Abhinavkrishna3211/CamoBots/hardware/blaster.pdf

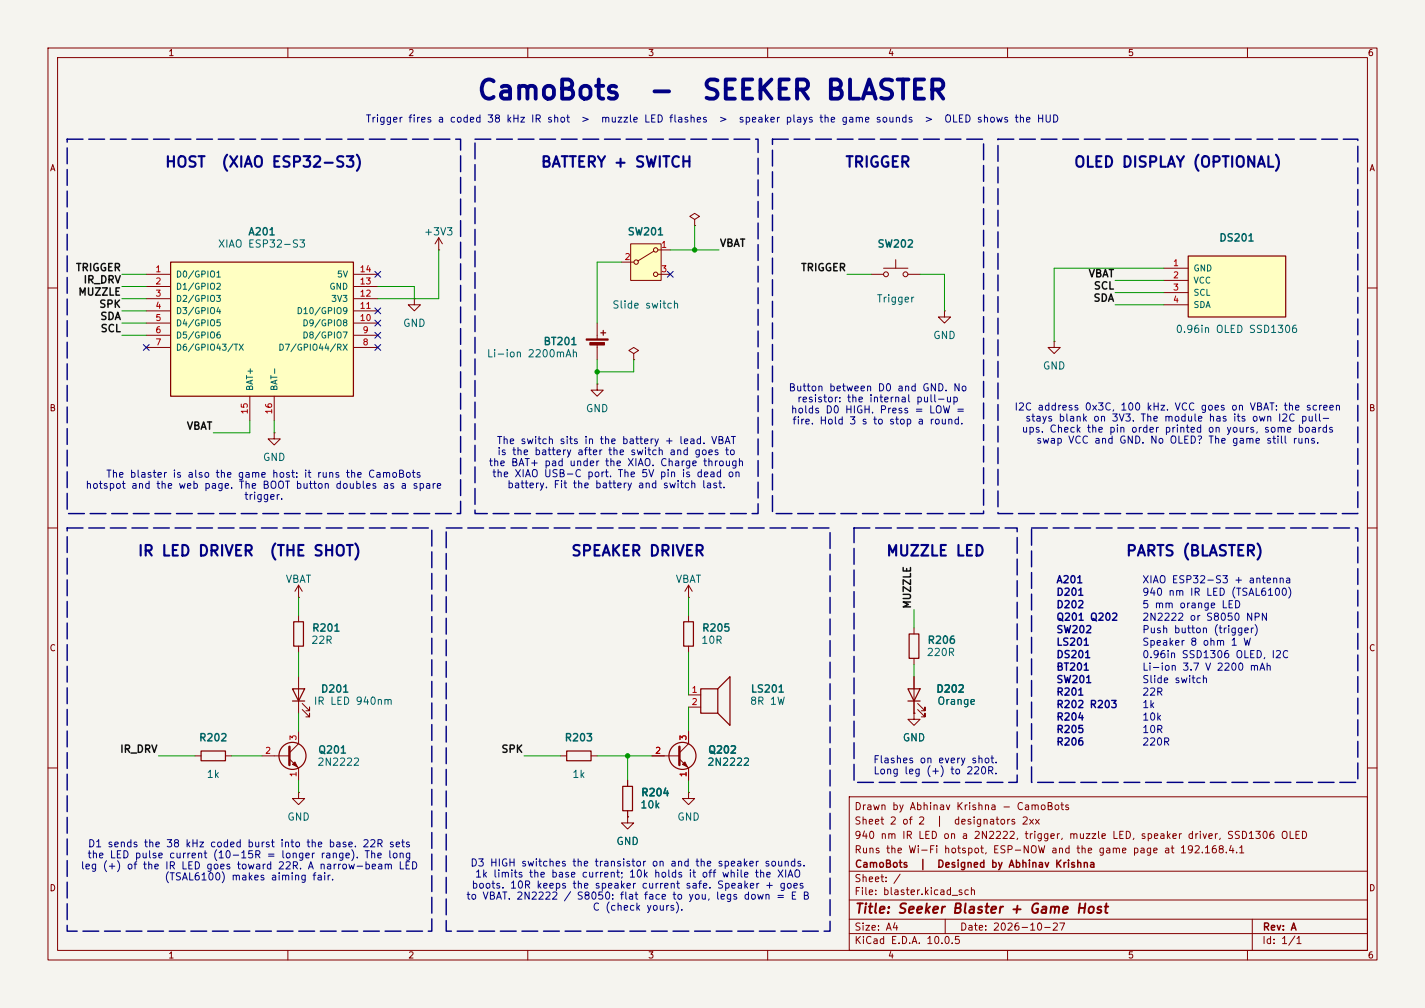
[picture p3: page 1]

I2C address 0x3C, 100 kHz. VCC goes on VBAT: the screen CamoBots - SEEKER BLASTER

Trigger fires a coded 38 kHz IR shot > muzzle LED flashes > speaker plays the game sounds > OLED shows the HUD

Button between D0 and GND. No
resistor: the internal pull-up
holds D0 HIGH. Press = LOW =
fire. Hold 3 s to stop a round.

stays blank on 3V3. The module has its own I2C pull-
swap VCC and GND. No OLED? The game still runs. ups. Check the pin order printed on yours, some boards

The switch sits in the battery + lead. VBAT
is the battery after the switch and goes to
the BAT+ pad under the XIAO. Charge through
the XIAO USB-C port. The 5V pin is dead on
battery. Fit the battery and switch last.

The blaster is also the game host: it runs the CamoBots
hotspot and the web page. The BOOT button doubles as a spare

IR LED DRIVER (THE SHOT)

Flashes on every shot.
Long leg (+) to 220R.

Drawn by Abhinav Krishna - CamoBots
Sheet 2 of 2 | designators 2xx
940 nm IR LED on a 2N2222, trigger, muzzle LED, speaker driver, SSD1306 OLED
Runs the Wi-Fi hotspot, ESP-NOW and the game page at 192.168.4.1
CamoBots | Designed by Abhinav Krishna
Sheet: /
File: blaster.kicad_sch
Title: Seeker Blaster + Game Host

D1 sends the 38 kHz coded burst into the base. 22R sets
the LED pulse current (10-15R = longer range). The long
leg (+) of the IR LED goes toward 22R. A narrow-beam LED

D3 HIGH switches the transistor on and the speaker sounds.
1k limits the base current; 10k holds it off while the XIAO
boots. 10R keeps the speaker current safe. Speaker + goes
to VBAT. 2N2222 / S8050: flat face to you, legs down = E B

Size: A4 | Rev: A
KiCad E.D.A. 10.0.5 | Id: 1/1
