Abhinavkrishna3211/CamoBots/hardware/body.pdf

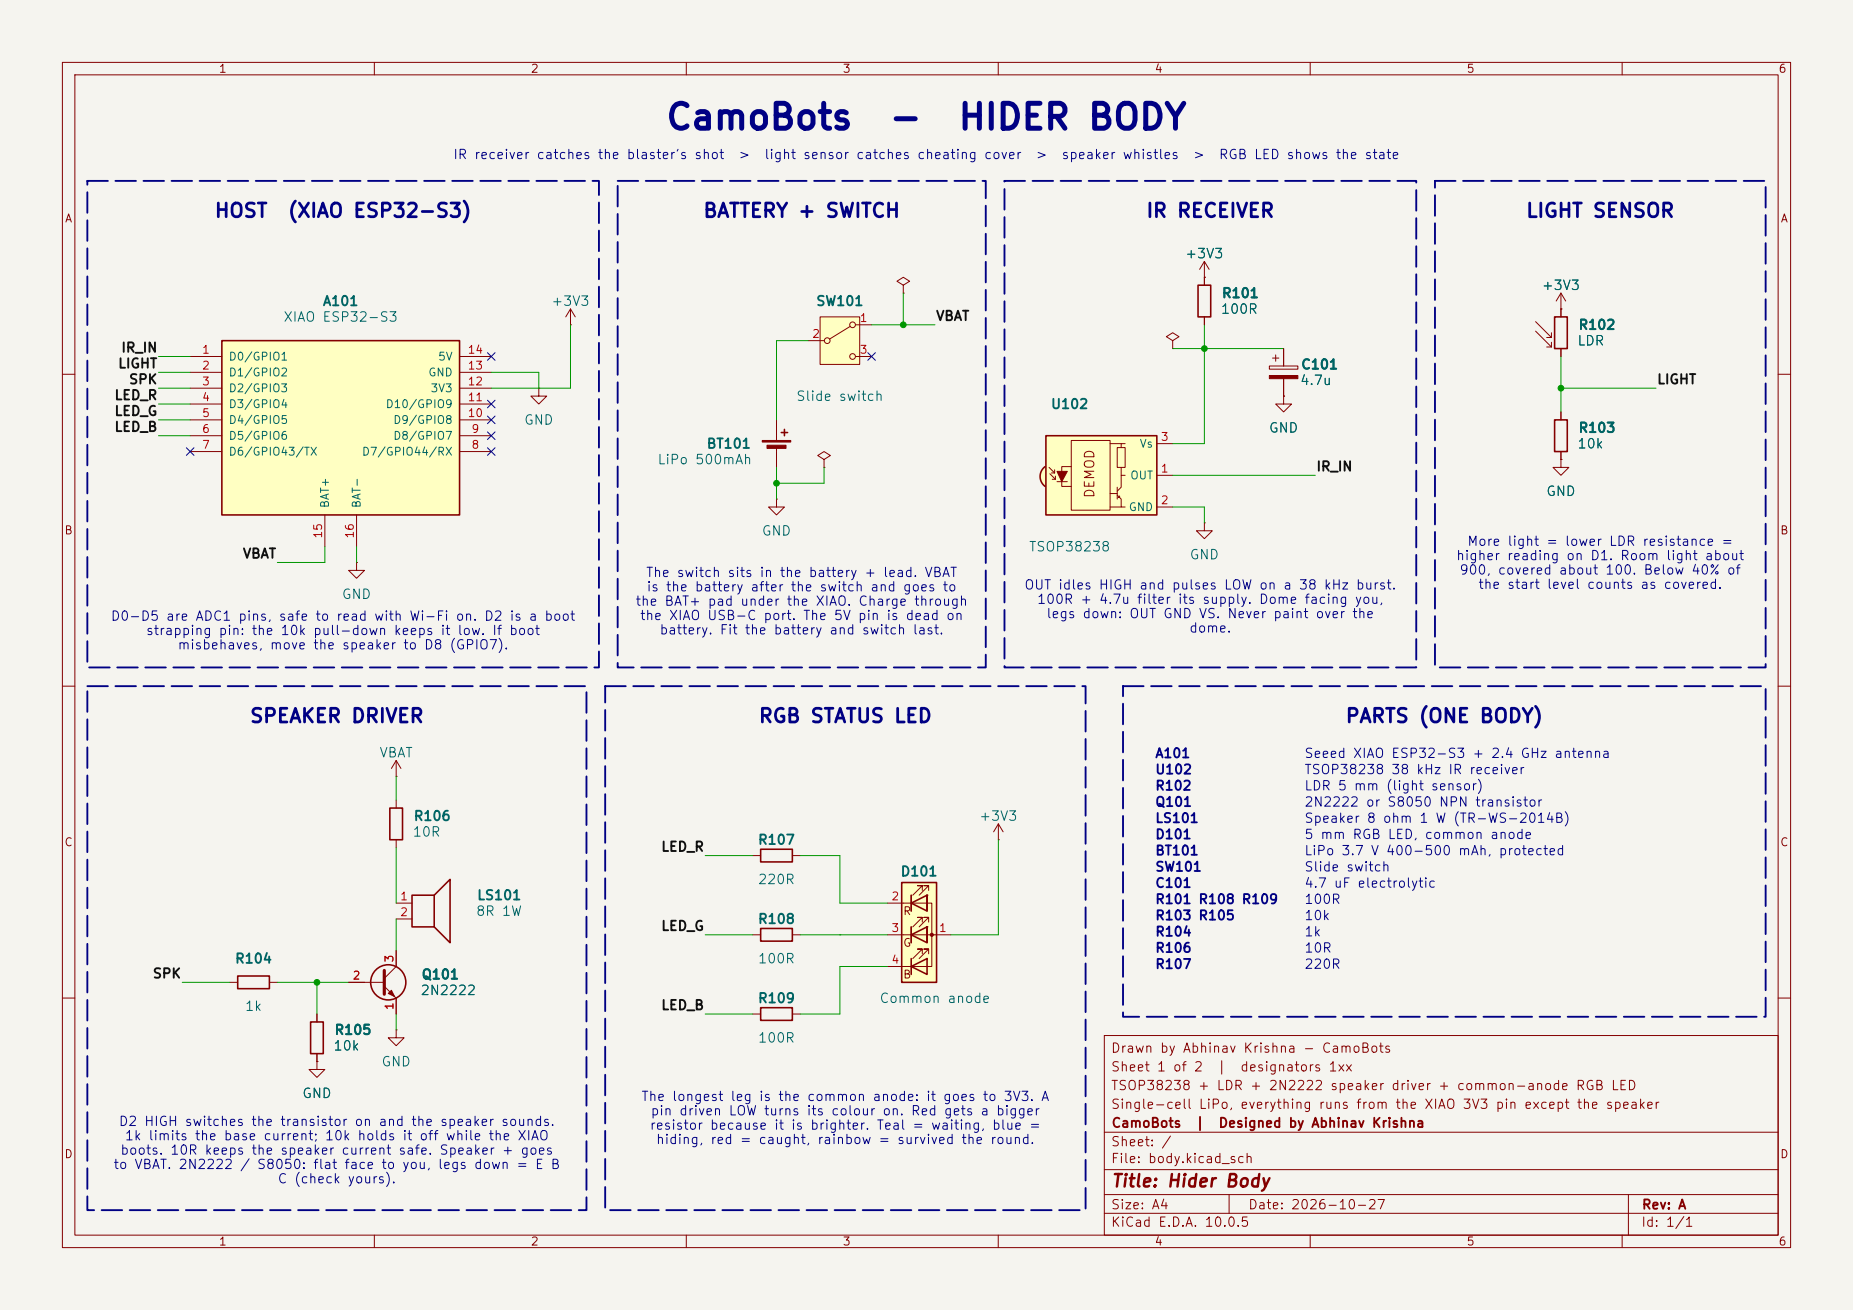
[picture p4: page 1]

IR receiver catches the blaster's shot > light sensor catches cheating cover > speaker whistles > RGB LED shows the state

More light = lower LDR resistance =
higher reading on D1. Room light about
900, covered about 100. Below 40% of
the start level counts as covered.

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

OUT idles HIGH and pulses LOW on a 38 kHz burst.
100R + 4.7u filter its supply. Dome facing you,
legs down: OUT GND VS. Never paint over the

D0-D5 are ADC1 pins, safe to read with Wi-Fi on. D2 is a boot

strapping pin: the 10k pull-down keeps it low. If boot
misbehaves, move the speaker to D8 (GPIO7).

Seeed XIAO ESP32-S3 + 2.4 GHz antenna
TSOP38238 38 kHz IR receiver
LDR 5 mm (light sensor)
2N2222 or S8050 NPN transistor
Speaker 8 ohm 1 W (TR-WS-2014B)
5 mm RGB LED, common anode
LiPo 3.7 V 400-500 mAh, protected
Slide switch
4.7 uF electrolytic

Drawn by Abhinav Krishna - CamoBots
Sheet 1 of 2 | designators 1xx
TSOP38238 + LDR + 2N2222 speaker driver + common-anode RGB LED
Single-cell LiPo, everything runs from the XIAO 3V3 pin except the speaker
CamoBots | Designed by Abhinav Krishna
Sheet: /
File: body.kicad_sch
Title: Hider Body

The longest leg is the common anode: it goes to 3V3. A
pin driven LOW turns its colour on. Red gets a bigger
resistor because it is brighter. Teal = waiting, blue =
hiding, red = caught, rainbow = survived the round.

D2 HIGH switches the transistor on and the speaker sounds.
1k limits the base current; 10k holds it off while the XIAO
boots. 10R keeps the speaker current safe. Speaker + goes
to VBAT. 2N2222 / S8050: flat face to you, legs down = E B

Size: A4 | Rev: A
KiCad E.D.A. 10.0.5 | Id: 1/1
