Abhinavkrishna3211/CamoBots/hardware/blaster.kicad_sch

## KiCad design hardware/blaster.kicad_sch (2026-10-26)

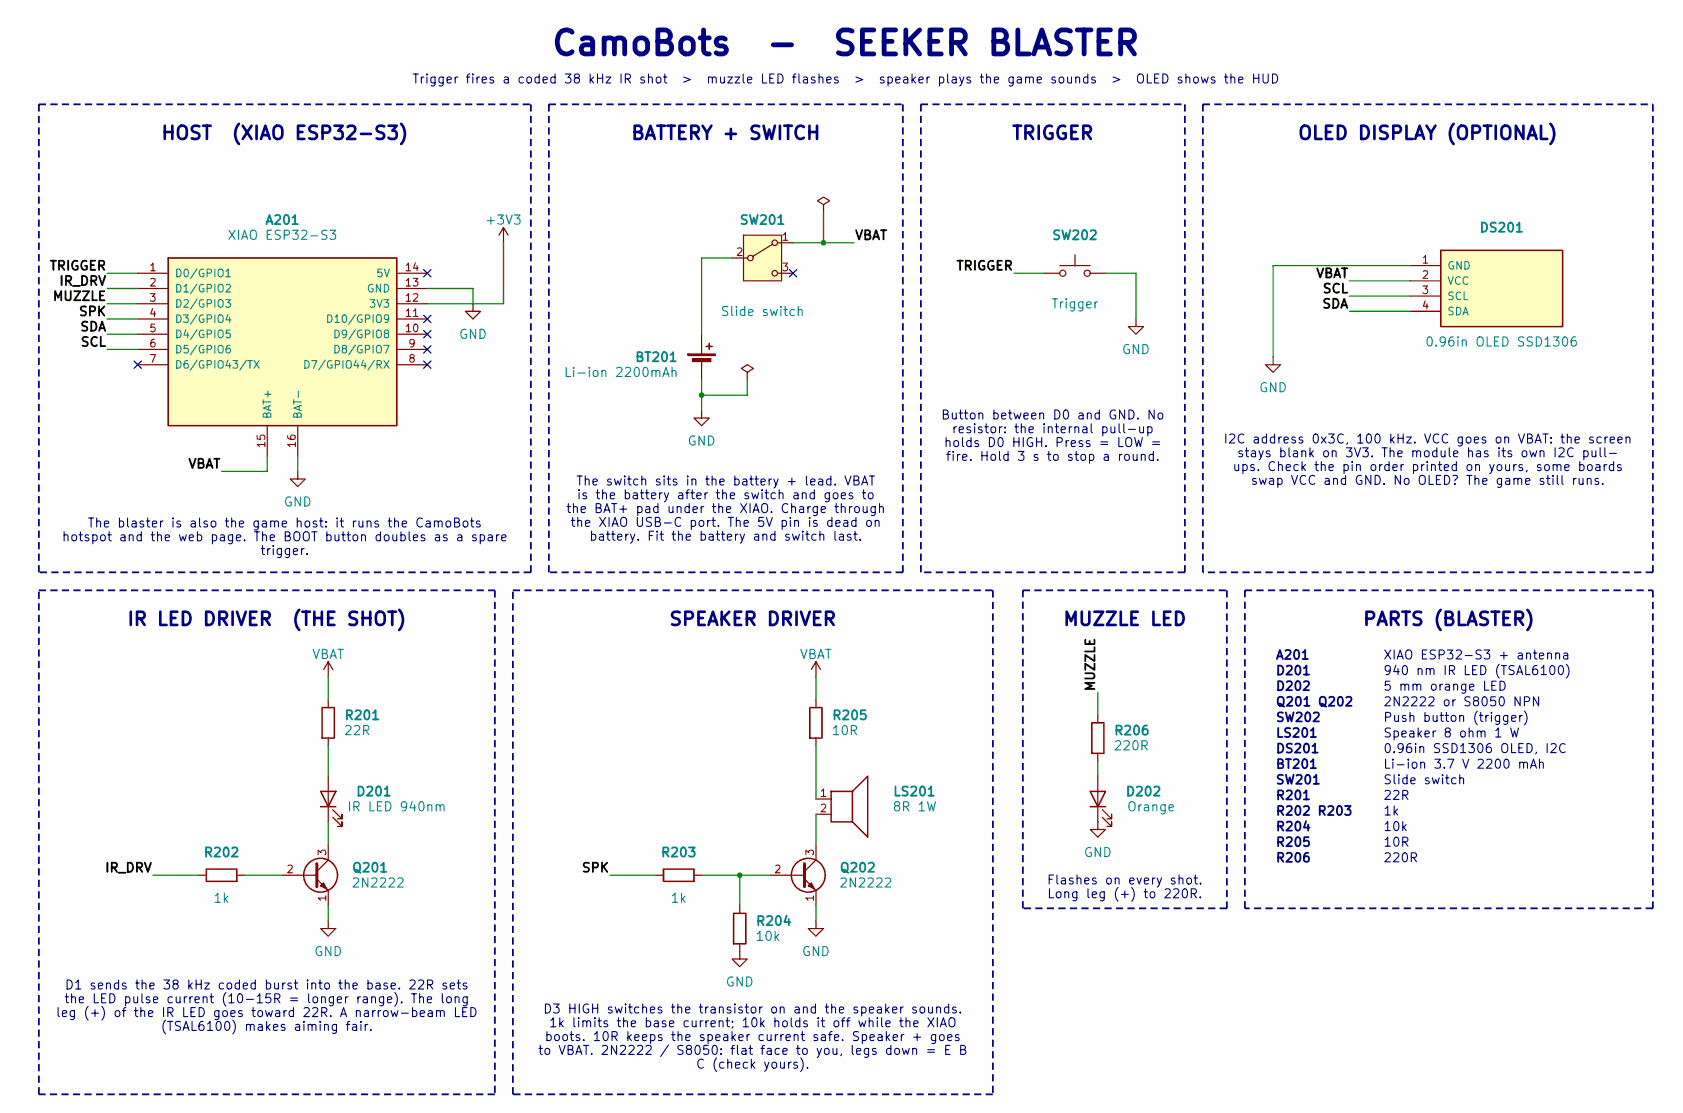
[picture p5: schematic blaster.kicad_sch]

Parts:
A201: XIAO ESP32-S3
BT201: Li-ion 2200mAh
D201: IR LED 940nm
D202: Orange
DS201: 0.96in OLED SSD1306
LS201: 8R 1W
Q201, Q202: 2N2222
R201: 22R
R202, R203: 1k
R204: 10k
R205: 10R
R206: 220R
SW201: Slide switch
SW202: Trigger

Connections:
+3V3: A201.12 (3V3), A201.13 (GND), A201.16 (BAT-), BT201.2 (-), D202.1 (K), DS201.1 (GND), Q201.1 (E), Q202.1 (E), R204.2, SW202.2
IR_DRV: A201.2 (D1/GPIO2), R202.1
MUZZLE: A201.3 (D2/GPIO3), R206.1
unnamed: BT201.1 (+), SW201.2 (B)
unnamed: D201.1 (K), Q201.3 (C)
unnamed: D201.2 (A), R201.2
unnamed: D202.2 (A), R206.2
unnamed: LS201.1, R205.2
unnamed: LS201.2, Q202.3 (C)
unnamed: Q201.2 (B), R202.2
unnamed: Q202.2 (B), R203.2, R204.1
SCL: A201.6 (D5/GPIO6), DS201.3 (SCL)
SDA: A201.5 (D4/GPIO5), DS201.4 (SDA)
SPK: A201.4 (D3/GPIO4), R203.1
TRIGGER: A201.1 (D0/GPIO1), SW202.1
VBAT: A201.15 (BAT+), DS201.2 (VCC), R201.1, R205.1, SW201.1 (A)

Notes on the sheet:
CamoBots - SEEKER BLASTER
Trigger fires a coded 38 kHz IR shot > muzzle LED flashes > speaker plays the game sounds > OLED shows the HUD
HOST (XIAO ESP32-S3)
The blaster is also the game host: it runs the CamoBots
hotspot and the web page. The BOOT button doubles as a spare
trigger.
BATTERY + SWITCH
The switch sits in the battery + lead. VBAT
is the battery after the switch and goes to
the BAT+ pad under the XIAO. Charge through
the XIAO USB-C port. The 5V pin is dead on
battery. Fit the battery and switch last.
TRIGGER
Button between D0 and GND. No
resistor: the internal pull-up
holds D0 HIGH. Press = LOW =
fire. Hold 3 s to stop a round.
OLED DISPLAY (OPTIONAL)
I2C address 0x3C, 100 kHz. VCC goes on VBAT: the screen
stays blank on 3V3. The module has its own I2C pull-
ups. Check the pin order printed on yours, some boards
swap VCC and GND. No OLED? The game still runs.
IR LED DRIVER (THE SHOT)
D1 sends the 38 kHz coded burst into the base. 22R sets
the LED pulse current (10-15R = longer range). The long
leg (+) of the IR LED goes toward 22R. A narrow-beam LED
(TSAL6100) makes aiming fair.
SPEAKER DRIVER
D3 HIGH switches the transistor on and the speaker sounds.
1k limits the base current; 10k holds it off while the XIAO
boots. 10R keeps the speaker current safe. Speaker + goes
to VBAT. 2N2222 / S8050: flat face to you, legs down = E B
C (check yours).
MUZZLE LED
Flashes on every shot.
Long leg (+) to 220R.
PARTS (BLASTER)
A201
XIAO ESP32-S3 + antenna
D201
940 nm IR LED (TSAL6100)
D202
5 mm orange LED
Q201 Q202
2N2222 or S8050 NPN
SW202
Push button (trigger)
LS201
Speaker 8 ohm 1 W
DS201
0.96in SSD1306 OLED, I2C
BT201
Li-ion 3.7 V 2200 mAh
SW201
Slide switch
R201
22R
R202 R203
R204
10k
R205
10R
R206
220R
