Abhinavkrishna3211/CamoBots/hardware/body.kicad_sch

## KiCad design hardware/body.kicad_sch (2026-10-26)

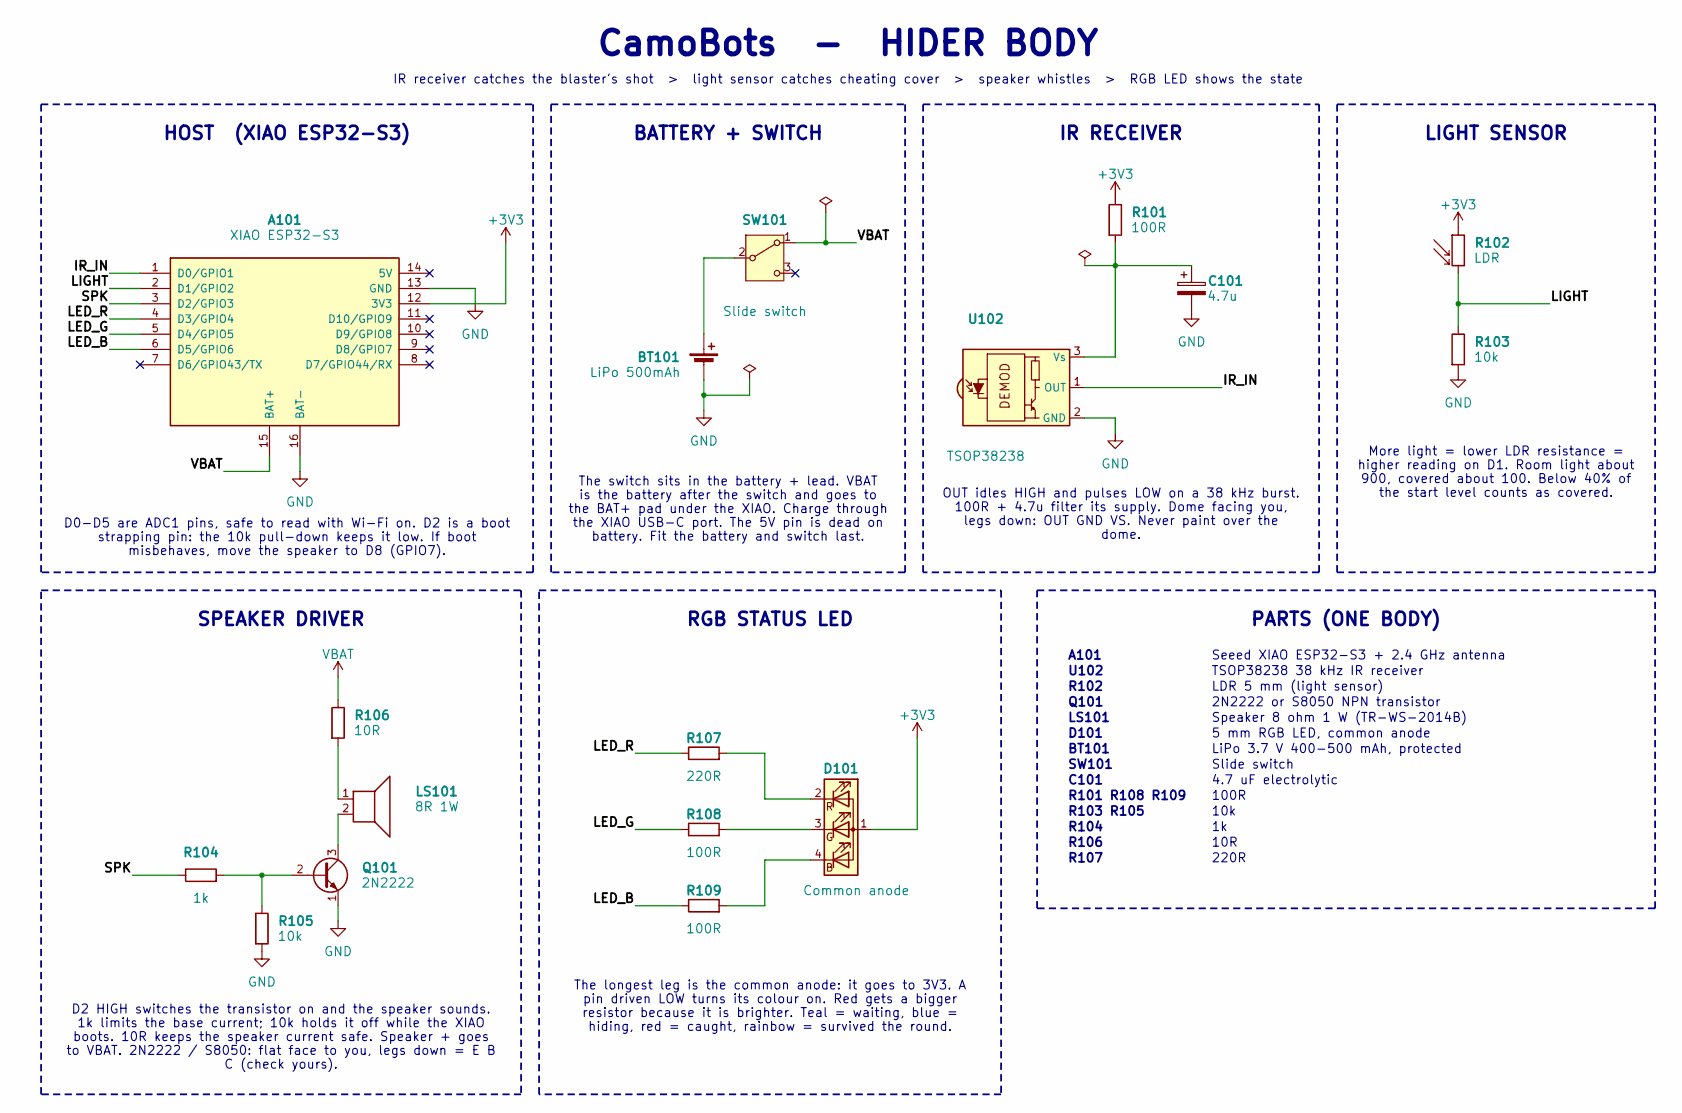
[picture p6: schematic body.kicad_sch]

Parts:
A101: XIAO ESP32-S3
BT101: LiPo 500mAh
C101: 4.7u
D101: Common anode
LS101: 8R 1W
Q101: 2N2222
R101, R108, R109: 100R
R102: LDR
R103, R105: 10k
R104: 1k
R106: 10R
R107: 220R
SW101: Slide switch
U102: TSOP38238

Connections:
+3V3: A101.12 (3V3), A101.13 (GND), A101.16 (BAT-), BT101.2 (-), C101.2, D101.1 (A), Q101.1 (E), R101.1, R102.1, R103.2, R105.2, U102.2 (GND)
IR_IN: A101.1 (D0/GPIO1), U102.1 (OUT)
LED_B: A101.6 (D5/GPIO6), R109.1
LED_G: A101.5 (D4/GPIO5), R108.1
LED_R: A101.4 (D3/GPIO4), R107.1
LIGHT: A101.2 (D1/GPIO2), R102.2, R103.1
unnamed: BT101.1 (+), SW101.2 (B)
unnamed: C101.1, R101.2, U102.3 (Vs)
unnamed: D101.2 (RK), R107.2
unnamed: D101.3 (GK), R108.2
unnamed: D101.4 (BK), R109.2
unnamed: LS101.1, R106.2
unnamed: LS101.2, Q101.3 (C)
unnamed: Q101.2 (B), R104.2, R105.1
SPK: A101.3 (D2/GPIO3), R104.1
VBAT: A101.15 (BAT+), R106.1, SW101.1 (A)

Notes on the sheet:
CamoBots - HIDER BODY
IR receiver catches the blaster's shot > light sensor catches cheating cover > speaker whistles > RGB LED shows the state
HOST (XIAO ESP32-S3)
D0-D5 are ADC1 pins, safe to read with Wi-Fi on. D2 is a boot
strapping pin: the 10k pull-down keeps it low. If boot
misbehaves, move the speaker to D8 (GPIO7).
BATTERY + SWITCH
The switch sits in the battery + lead. VBAT
is the battery after the switch and goes to
the BAT+ pad under the XIAO. Charge through
the XIAO USB-C port. The 5V pin is dead on
battery. Fit the battery and switch last.
IR RECEIVER
OUT idles HIGH and pulses LOW on a 38 kHz burst.
100R + 4.7u filter its supply. Dome facing you,
legs down: OUT GND VS. Never paint over the
dome.
LIGHT SENSOR
More light = lower LDR resistance =
higher reading on D1. Room light about
900, covered about 100. Below 40% of
the start level counts as covered.
SPEAKER DRIVER
D2 HIGH switches the transistor on and the speaker sounds.
1k limits the base current; 10k holds it off while the XIAO
boots. 10R keeps the speaker current safe. Speaker + goes
to VBAT. 2N2222 / S8050: flat face to you, legs down = E B
C (check yours).
RGB STATUS LED
The longest leg is the common anode: it goes to 3V3. A
pin driven LOW turns its colour on. Red gets a bigger
resistor because it is brighter. Teal = waiting, blue =
hiding, red = caught, rainbow = survived the round.
PARTS (ONE BODY)
A101
Seeed XIAO ESP32-S3 + 2.4 GHz antenna
U102
TSOP38238 38 kHz IR receiver
R102
LDR 5 mm (light sensor)
Q101
2N2222 or S8050 NPN transistor
LS101
Speaker 8 ohm 1 W (TR-WS-2014B)
D101
5 mm RGB LED, common anode
BT101
LiPo 3.7 V 400-500 mAh, protected
SW101
Slide switch
C101
4.7 uF electrolytic
R101 R108 R109
100R
R103 R105
10k
R104
R106
10R
R107
220R
