Abhinavkrishna3211/CamoBots/src/bell_pcm.h

#pragma once
// Hunt start: an alarm bell rung six times, then ringing out.
// 8-bit unsigned PCM, 16 kHz. Synthesized from sine partials, not sampled from anything.
static const uint8_t BELL_PCM[32000] = {
  0, 8, 10, 25, 32, 30, 28, 44, 114, 132, 96, 127, 98, 71, 55, 59, 40, 78, 83, 150, 73, 61, 75, 170,
  182, 220, 182, 136, 155, 53, 85, 126, 69, 54, 98, 128, 115, 113, 120, 170, 218, 214, 198, 176, 69, 41, 83, 129,
  119, 58, 85, 132, 144, 139, 179, 184, 200, 190, 167, 144, 47, 43, 85, 121, 124, 68, 72, 96, 160, 175, 220, 201,
  151, 179, 149, 103, 53, 46, 79, 135, 104, 102, 116, 85, 150, 214, 229, 207, 134, 96, 121, 91, 51, 76, 76, 97,
  113, 138, 121, 120, 143, 224, 234, 172, 122, 69, 70, 86, 92, 98, 99, 62, 95, 173, 147, 156, 175, 207, 217, 163,
  78, 69, 53, 62, 139, 128, 89, 60, 88, 180, 198, 181, 190, 202, 154, 137, 92, 59, 56, 59, 136, 155, 93, 56,
  122, 169, 211, 217, 189, 169, 94, 85, 111, 87, 45, 81, 122, 131, 119, 78, 142, 189, 207, 221, 205, 102, 58, 73,
  96, 122, 64, 74, 113, 113, 118, 158, 169, 180, 209, 202, 195, 82, 34, 67, 111, 113, 103, 89, 76, 116, 134, 203,
  209, 169, 179, 190, 146, 71, 49, 53, 117, 110, 112, 120, 72, 93, 177, 223, 215, 183, 125, 144, 114, 60, 78, 73,
  81, 106, 134, 119, 106, 99, 188, 235, 208, 169, 111, 80, 74, 88, 95, 103, 70, 71, 155, 140, 128, 150, 197, 221,
  207, 140, 92, 63, 40, 110, 138, 102, 68, 71, 131, 176, 171, 179, 213, 179, 169, 141, 79, 51, 47, 100, 156, 122,
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
  97, 90, 109, 83, 52, 87, 120, 133, 113, 89, 148, 187, 206, 217, 194, 97, 64, 76, 104, 115, 67, 81, 113, 114,
  123, 159, 167, 183, 205, 200, 182, 76, 40, 74, 113, 111, 103, 87, 83, 116, 141, 201, 202, 168, 179, 184, 136, 72,
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
