Abhinavkrishna3211/CamoBots/src/paintball_pcm.h

#pragma once
// Blaster fire: low pneumatic pop and a puff of air.
// 8-bit unsigned PCM, 16 kHz. Synthesized from shaped noise and tones, not sampled from anything.
static const uint8_t PAINTBALL_PCM[3520] = {
1, 1, 2, 3, 5, 1, 2, 84, 158, 201, 235, 247, 252, 254, 254, 84, 255, 244, 217, 6,
254, 254, 1, 2, 35, 1, 1, 1, 1, 1, 1, 1, 1, 1, 1, 1, 1, 1, 1, 13,
4, 132, 143, 249, 255, 255, 255, 255, 255, 255, 255, 255, 255, 255, 255, 255, 255, 255, 255, 254,
254, 188, 252, 57, 71, 1, 1, 1, 4, 1, 1, 1, 1, 1, 1, 1, 1, 1, 1, 2,
1, 2, 2, 6, 254, 239, 242, 201, 255, 251, 255, 255, 255, 255, 255, 255, 255, 255, 255, 255,
254, 255, 254, 248, 255, 32, 253, 1, 1, 7, 1, 1, 4, 1, 1, 2, 1, 1, 1, 1,
1, 1, 1, 235, 1, 2, 230, 12, 3, 255, 255, 1, 255, 255, 253, 255, 255, 255, 105, 255,
253, 255, 254, 255, 255, 255, 255, 2, 252, 2, 165, 215, 1, 2, 7, 1, 1, 1, 1, 1,
1, 1, 1, 1, 1, 2, 1, 1, 254, 1, 253, 229, 1, 254, 255, 109, 254, 255, 255, 255,
255, 255, 255, 253, 255, 255, 238, 255, 22, 255, 255, 1, 255, 255, 1, 226, 65, 1, 1, 1,
1, 84, 1, 1, 3, 1, 1, 1, 1, 1, 219, 5, 1, 9, 234, 254, 84, 248, 253, 255,
255, 234, 255, 255, 255, 254, 255, 251, 255, 255, 254, 253, 255, 255, 245, 3, 255, 2, 2, 251,
217, 1, 1, 1, 1, 1, 1, 1, 1, 11, 1, 65, 1, 113, 3, 1, 3, 158, 204, 95,
154, 199, 255, 254, 255, 254, 248, 255, 255, 255, 254, 255, 255, 255, 254, 233, 255, 196, 255, 12,
252, 5, 191, 2, 9, 199, 37, 1, 1, 1, 3, 1, 1, 1, 1, 2, 37, 1, 1, 27,
1, 8, 74, 12, 224, 217, 253, 217, 253, 255, 255, 253, 255, 247, 255, 255, 255, 255, 254, 255,
255, 255, 158, 255, 13, 182, 234, 213, 1, 246, 249, 1, 60, 1, 3, 1, 1, 1, 22, 1,
3, 2, 95, 1, 3, 26, 3, 1, 11, 252, 251, 251, 233, 193, 255, 255, 254, 245, 255, 254,
255, 255, 254, 251, 255, 120, 255, 248, 251, 255, 2, 154, 253, 6, 21, 193, 1, 6, 1, 165,
1, 1, 2, 1, 1, 209, 1, 1, 95, 1, 7, 29, 25, 1, 34, 254, 3, 253, 254, 95,
255, 251, 243, 254, 254, 255, 235, 255, 211, 255, 255, 231, 240, 255, 191, 255, 1, 255, 147, 29,
47, 1, 41, 22, 1, 12, 1, 4, 3, 1, 1, 6, 1, 45, 2, 14, 1, 4, 2, 215,
6, 247, 253, 71, 37, 254, 250, 151, 255, 251, 255, 255, 254, 196, 255, 253, 255, 250, 253, 109,
254, 255, 5, 22, 245, 16, 253, 3, 17, 2, 113, 1, 14, 11, 1, 1, 1, 2, 4, 2,
60, 2, 4, 12, 2, 60, 2, 254, 206, 35, 16, 182, 253, 253, 253, 248, 254, 255, 217, 255,
254, 254, 246, 255, 255, 254, 7, 230, 247, 255, 253, 1, 243, 4, 188, 236, 3, 2, 1, 9,
23, 247, 1, 1, 1, 109, 41, 2, 3, 1, 102, 3, 3, 221, 91, 37, 39, 252, 231, 12,
254, 255, 255, 175, 120, 252, 255, 234, 255, 209, 246, 254, 236, 255, 227, 255, 6, 191, 252, 3,
254, 34, 74, 1, 147, 2, 60, 1, 250, 1, 3, 1, 45, 9, 1, 241, 20, 3, 1, 2,
254, 4, 4, 204, 201, 217, 235, 254, 11, 252, 250, 251, 247, 255, 242, 255, 172, 250, 254, 252,
250, 252, 35, 254, 243, 238, 222, 15, 234, 211, 45, 1, 4, 234, 2, 65, 3, 1, 6, 15,
1, 2, 13, 147, 55, 1, 3, 219, 221, 4, 143, 9, 230, 211, 15, 233, 255, 19, 68, 255,
253, 120, 254, 254, 246, 254, 253, 254, 151, 237, 242, 253, 236, 251, 191, 30, 251, 14, 4, 132,
132, 235, 1, 3, 6, 139, 3, 1, 12, 3, 7, 17, 2, 68, 3, 3, 25, 191, 6, 88,
63, 231, 41, 196, 217, 233, 45, 254, 250, 255, 182, 247, 248, 253, 249, 254, 237, 236, 250, 242,
251, 237, 246, 39, 248, 139, 52, 60, 117, 2, 71, 215, 3, 55, 3, 9, 2, 21, 7, 7,
27, 4, 2, 45, 5, 196, 158, 2, 25, 172, 201, 5, 240, 252, 68, 251, 196, 233, 120, 255,
245, 239, 249, 230, 254, 255, 206, 47, 255, 237, 224, 98, 139, 253, 139, 222, 26, 165, 81, 20,
45, 13, 4, 84, 50, 9, 1, 27, 20, 3, 98, 2, 35, 8, 8, 6, 226, 27, 27, 7,
239, 41, 120, 251, 6, 252, 253, 105, 109, 253, 255, 26, 224, 255, 245, 249, 240, 178, 252, 204,
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
};
