Abhinavkrishna3211/CamoBots/src/splat_pcm.h

#pragma once
// Captured body: paint ball hit, then a wet splash that sloshes away.
// 8-bit unsigned PCM, 16 kHz. Synthesized from shaped noise and tones, not sampled from anything.
static const uint8_t SPLAT_PCM[16000] = {
1, 1, 1, 1, 1, 1, 1, 3, 104, 160, 104, 246, 255, 255, 254, 255, 255, 254, 33, 1,
1, 1, 3, 88, 252, 255, 68, 1, 1, 5, 17, 1, 1, 1, 1, 2, 1, 1, 1, 1,
1, 1, 1, 1, 1, 1, 1, 1, 1, 1, 88, 81, 1, 1, 1, 9, 37, 88, 249, 255,
235, 50, 62, 68, 12, 17, 250, 255, 255, 254, 235, 252, 226, 235, 255, 255, 255, 255, 255, 255,
255, 255, 255, 255, 255, 251, 144, 128, 247, 255, 255, 253, 219, 144, 168, 136, 5, 1, 1, 1,
1, 1, 1, 1, 30, 1, 1, 1, 1, 1, 1, 1, 1, 1, 1, 1, 1, 1, 2, 37,
182, 88, 17, 3, 1, 1, 26, 96, 206, 244, 254, 255, 255, 255, 255, 255, 255, 255, 255, 255,
255, 255, 255, 255, 253, 223, 239, 255, 255, 255, 253, 128, 17, 13, 17, 9, 2, 1, 1, 6,
2, 1, 1, 2, 1, 1, 1, 1, 1, 1, 1, 1, 1, 1, 1, 1, 1, 1, 4, 4,
4, 2, 5, 62, 128, 144, 239, 255, 255, 255, 246, 232, 255, 255, 255, 255, 255, 255, 255, 255,
255, 255, 255, 255, 255, 255, 255, 254, 188, 235, 247, 250, 247, 26, 2, 6, 68, 50, 9, 1,
1, 1, 1, 1, 1, 1, 1, 1, 1, 1, 1, 1, 1, 1, 2, 3, 1, 1, 1, 1,
1, 1, 7, 37, 37, 81, 211, 160, 13, 6, 3, 2, 128, 255, 255, 254, 253, 255, 255, 255,
255, 255, 255, 255, 255, 255, 255, 255, 255, 254, 252, 250, 248, 254, 255, 252, 235, 104, 4, 3,
13, 8, 2, 1, 2, 5, 3, 2, 2, 1, 1, 1, 1, 3, 3, 2, 1, 1, 1, 1,
2, 10, 19, 6, 2, 6, 104, 206, 168, 88, 74, 194, 250, 252, 250, 253, 253, 251, 252, 254,
255, 255, 255, 255, 255, 255, 255, 255, 255, 255, 255, 255, 254, 247, 243, 215, 194, 226, 223, 230,
237, 194, 136, 112, 24, 2, 1, 2, 5, 4, 1, 1, 1, 1, 1, 1, 1, 1, 1, 1,
1, 2, 9, 10, 3, 2, 2, 2, 3, 45, 175, 152, 74, 104, 211, 252, 255, 255, 252, 249,
253, 254, 254, 254, 255, 255, 255, 255, 255, 255, 255, 254, 254, 250, 247, 252, 253, 252, 247, 188,
104, 136, 144, 112, 81, 33, 5, 3, 4, 3, 2, 2, 3, 3, 1, 1, 1, 2, 2, 2,
1, 1, 1, 1, 2, 2, 4, 6, 5, 5, 11, 30, 45, 62, 96, 120, 160, 230, 247, 248,
249, 251, 253, 254, 255, 255, 255, 255, 255, 255, 255, 255, 255, 255, 254, 253, 254, 254, 251, 241,
223, 215, 175, 88, 104, 112, 41, 11, 6, 5, 5, 3, 2, 2, 2, 2, 1, 1, 1, 1,
2, 1, 1, 1, 2, 2, 2, 1, 1, 2, 7, 15, 11, 10, 33, 96, 96, 120, 211, 244,
245, 243, 245, 251, 254, 254, 251, 250, 254, 255, 255, 254, 252, 251, 253, 255, 255, 255, 254, 254,
254, 252, 246, 223, 112, 81, 144, 120, 21, 3, 3, 12, 37, 26, 10, 8, 12, 9, 6, 2,
1, 1, 2, 2, 1, 1, 5, 81, 4, 1, 1, 8, 68, 33, 8, 9, 17, 45, 226, 254,
252, 194, 211, 232, 248, 251, 194, 62, 200, 252, 247, 243, 254, 254, 254, 255, 255, 255, 255, 255,
255, 255, 215, 15, 19, 37, 37, 104, 232, 239, 175, 241, 255, 226, 1, 1, 45, 182, 13, 9,
11, 12, 24, 6, 96, 251, 6, 1, 1, 1, 1, 1, 6, 37, 13, 10, 250, 255, 56, 4,
245, 255, 251, 2, 1, 1, 128, 255, 255, 33, 255, 255, 255, 1, 9, 255, 255, 1, 1, 255,
255, 255, 255, 239, 24, 252, 255, 254, 255, 255, 255, 182, 1, 1, 9, 10, 6, 194, 252, 237,
1, 1, 1, 1, 1, 1, 1, 255, 255, 255, 253, 1, 1, 1, 230, 255, 255, 254, 17, 1,
1, 1, 1, 1, 3, 253, 255, 255, 255, 255, 255, 255, 255, 1, 1, 1, 255, 255, 255, 1,
2, 120, 120, 255, 255, 255, 200, 41, 255, 255, 250, 26, 26, 144, 241, 160, 30, 235, 244, 56,
1, 1, 250, 255, 255, 74, 1, 1, 1, 1, 1, 120, 255, 253, 4, 1, 1, 175, 11, 1,
1, 1, 12, 7, 10, 254, 255, 251, 250, 255, 255, 254, 254, 254, 175, 45, 253, 255, 45, 17,
255, 255, 252, 211, 88, 243, 255, 255, 194, 2, 3, 56, 175, 243, 254, 255, 250, 17, 50, 254,
255, 230, 2, 7, 68, 24, 2, 1, 56, 255, 255, 104, 1, 1, 1, 2, 1, 1, 1, 120,
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
};
