Abhinavkrishna3211/CamoBots/src/hw.h

#pragma once
// Sensors, light and sound. SIM fakes them over serial and the user LED;
// real builds drive the parts.
#include <Arduino.h>

enum Pix : uint8_t { PIX_OFF, PIX_IDLE, PIX_TICK, PIX_DARK, PIX_COVERED, PIX_CAPTURED, PIX_REVEAL,
                     PIX_LIVE, PIX_LOCKED, PIX_GO };
enum Snd : uint8_t { SND_BEEP, SND_WHISTLE, SND_TAUNT, SND_FANFARE, SND_BUZZ, SND_CELEBRATE, SND_FIRE, SND_BELL, SND_GO,
                      SND_TICK, SND_COMBO, SND_LAST };

void hw_begin();
void hw_update();              // call every loop: animations, serial commands
void hw_pixel(Pix p);
void hw_sound(Snd s);
uint16_t hw_ldr();             // body: 0..4095
int hw_ir_hit();               // body: shooter id of a decoded shot, or -1
uint32_t hw_beam_ms();         // body: ms spent in the seeker's scan beam since the last call
bool hw_trigger();             // blaster: true once per press
uint32_t hw_trigger_held();    // blaster: ms the trigger has been held, 0 when up
void hw_fire();                // blaster: send an IR shot frame
void hw_scan();                // blaster: send an IR scan frame (Missed Spot), skipped if IR is busy
void hw_ir_stats(uint32_t* edges, uint32_t* bad);  // body: raw TSOP edges and bad frames, for the bench
bool hw_cmd(String& out);      // next serial line not eaten by hw, for game commands
