Abhinavkrishna3211/CamoBots/(commit log)

2026-10-23 Add game state machine with simulated sensors
2026-10-23 Add part drivers, bench builds and lost message recovery
2026-10-24 Use a common-anode RGB LED on the body instead of a NeoPixel
2026-10-25 Replace the aim LED with a muzzle flash and fix the bench scan toggle
    [bench.cpp, hw.cpp]
2026-10-25 Power the OLED from 5V and run I2C at 100 kHz
2026-10-25 Ring a bell on every device when the hunt starts
2026-10-26 Add body and blaster schematics
    [blaster.kicad_sch, body.kicad_sch]
2026-10-26 Redraw schematics on A4 in KiCad colours with larger text
    [blaster.kicad_sch, body.kicad_sch]
